GhostVisitor/ESP-Mosaico-gamepad/PROTOCOL.md

# ESP-Mosaico 两用游戏手柄 ↔ 上级单片机 串口协议 & 按键对照表

> 面向**上级单片机**开发者。本文档描述 ESP-Mosaico 两用游戏手柄（CH552T 面板）通过 `P3.1 (TXD)` 上报的串口数据。
> 对应固件:`ESP-Mosaico_gamepad_v1.0.hex`

---

## 1. 物理层

| 项 | 值 |
|---|---|
| 接口 | UART0,**单向发送**(CH552 只发,不收) |
| 引脚 | CH552 `P3.1 = TXD` → 上级单片机 `RX`(另需共地 GND) |
| 电平 | 3.3 V TTL(注意与上级 MCU 电平匹配) |
| 格式 | **19200 bps, 8 数据位, 无校验, 1 停止位(19200 8N1)** |
| 流控 | 无 |

> CH552 的 RXD 在 `P3.0`,本固件未使能接收(`REN=0`)。上级若要回传数据,需自行接 P3.0 并改固件。

---

## 2. 帧格式(定长 5 字节)

```
字节0   字节1   字节2    字节3    字节4
0xA5    0x5A    LO       HI       XOR
帧头1   帧头2   掩码低8位  掩码高4位  校验
```

- `LO` = `mask & 0xFF`
- `HI` = `(mask >> 8) & 0x0F`(只用低 4 位,bit4~bit7 恒为 0)
- `XOR` = `0xA5 ^ 0x5A ^ LO ^ HI`(前 4 字节异或)

`mask` 是 **12 位键位掩码**,`bit n = KEY_(n+1)` 按下(`1` = 按下,`0` = 松开)。

---

## 3. ★ 按键键值对照表(核心)

| bit | mask(hex) | 按键 | 引脚 | 板上位置 | 手柄功能 | 典型帧(仅该键按下) |
|:---:|:---:|:----:|:----:|:---:|:---:|:---|
| 0 | `0x0001` | KEY_1  | P1.0 | SW1 | D-Pad 上 (hat=0) | `A5 5A 01 00 FE` |
| 1 | `0x0002` | KEY_2  | P1.1 | SW2 | D-Pad 左 (hat=6) | `A5 5A 02 00 FD` |
| 2 | `0x0004` | KEY_3  | P1.2 | SW3 | D-Pad 下 (hat=4) | `A5 5A 04 00 FB` |
| 3 | `0x0008` | KEY_4  | P1.3 | SW4 | D-Pad 右 (hat=2) | `A5 5A 08 00 F7` |
| 4 | `0x0010` | KEY_5  | P1.4 | SW5 | Y | `A5 5A 10 00 EF` |
| 5 | `0x0020` | KEY_6  | P1.5 | SW6 | X | `A5 5A 20 00 DF` |
| 6 | `0x0040` | KEY_7  | P1.6 | SW7 | A | `A5 5A 40 00 BF` |
| 7 | `0x0080` | KEY_8  | P1.7 | SW8 | B | `A5 5A 80 00 7F` |
| 8 | `0x0100` | KEY_9  | P3.2 | SW9 | SELECT → Back | `A5 5A 00 01 FE` |
| 9 | `0x0200` | KEY_10 | P3.3 | SW10  | START  → Start | `A5 5A 00 02 FD` |
| 10 | `0x0400` | KEY_11 | P3.4 | SW11  | LT | `A5 5A 00 04 FB` |
| 11 | `0x0800` | KEY_12 | P3.5 | SW12  | RT | `A5 5A 00 08 F7` |
| — | `0x0000` | (无) | — | — | 全松开(空闲) | `A5 5A 00 00 FF` |

**组合键**:多个位同时为 1。例:`0x0C00` = LT+RT 同时按 → `A5 5A 00 0C F3`(已实测通过)。
**注意**:`HI` 只用到低 4 位,所以 `mask` 有效范围是 `0x0000`~`0x0FFF`。

---

## 4. 发送时机

| 场景 | 行为 |
|---|---|
| 键位**发生变化**(按下或松开) | **立即**发送一帧 |
| 键位**保持不变** | 每 **≈400 ms** 发一帧"心跳"(`mask` 内容不变) |
| 上电 | 启动后立即发一帧(通常是 `00 00`) |

> 心跳周期的意义:上级即使一直没按键,也能确认面板在线。
> **实测心跳 388~422 ms**。代码里写的是"主循环 2ms × 100",但本平台上 `DLY_ms(2)` 实测约 4ms,
> 所以真实值约 400 ms。

**上线/掉线判定建议**:超过 **1~2 s** 没收到任何合法帧 ⇒ 判定面板离线。
`K9~K12` 独立按键的帧已实测,均会在按下/松开瞬间立刻发出。

---

## 5. 上级单片机解析代码(可直接抄)

```c
/* ============ 上级 MCU 侧:CH552 面板串口帧解析 ============ */
#include <stdint.h>

#define KP_HEAD0   0xA5
#define KP_HEAD1   0x5A

/* 最新的键位掩码: bit n = KEY_(n+1) 按下 */
volatile uint16_t g_key_mask = 0;

/* 键名表,便于打印调试 */
static const char *const KEY_NAME[12] = {
    "UP","LEFT","DOWN","RIGHT","Y","X","A","B",
    "SELECT","START","LT","RT"
};

/* 5 状态接收机:把 UART 收到的每个字节喂进来(放在接收中断里即可) */
void KP_feed(uint8_t b)
{
    static uint8_t st = 0, lo = 0, hi = 0;

    switch (st) {
    case 0:                                  /* 等帧头1 */
        if (b == KP_HEAD0) st = 1;
        break;
    case 1:                                  /* 等帧头2 */
        st = (b == KP_HEAD1) ? 2 : 0;
        break;
    case 2:                                  /* 掩码低字节 */
        lo = b; st = 3;
        break;
    case 3:                                  /* 掩码高字节 */
        hi = b; st = 4;
        break;
    case 4:                                  /* 校验 */
        if (b == (uint8_t)(KP_HEAD0 ^ KP_HEAD1 ^ lo ^ hi)) {
            g_key_mask = (uint16_t)lo | ((uint16_t)hi << 8);   /* 校验通过才更新 */
        }
        st = 0;
        break;
    default:
        st = 0;
        break;
    }
}

/* 使用示例:查询某个键是否按下 */
#define KEY_DOWN(n)   ((g_key_mask >> (n)) & 1u)     /* n = 0..11 */
/* 例:  if (KEY_DOWN(10)) { /* LT 按下 */ }  */
```

### 关键点

1. **必须校验 XOR**,并且只在校验通过时更新 `g_key_mask`(防串扰/丢字节)。
2. 状态机在**每个字节**上推进,不依赖定时;**乱码会自动回到等帧头**。
3. `g_key_mask` 是**全量状态**(不是"事件"),所以丢一两帧也能在下一帧(≤400 ms 内)自动恢复。
4. 若要"按下瞬间触发一次"的语义,请在上级自己做**边沿检测**:
   ```c
   uint16_t prev = 0;
   ...
   uint16_t changed = g_key_mask ^ prev;      /* 变化的位 */
   uint16_t pressed = g_key_mask & changed;   /* 刚按下的位 */
   uint16_t released = prev & changed;        /* 刚松开的位 */
   prev = g_key_mask;
   ```
5. 面板侧已有 **≈16 ms 消抖**,上级**不需要**再消抖。

---

## 6. 附:同时上报的 USB 手柄(仅供参考,与串口无关)

面板同时把自己虚拟成一个 USB HID 手柄(VID:PID = `0x0079:0x0006`),
报告 7 字节:`[X, Y, Rx, Ry, hat+pad, btnLo, btnHi]`,按键顺序按 W3C 标准手柄布局:

| 标准按钮位 | 0 | 1 | 2 | 3 | 4 | 5 | 6 | 7 | 8 | 9 |
|---|---|---|---|---|---|---|---|---|---|---|
| 功能 | A | B | X | Y | LB | RB | LT | RT | Back | Start |
| 来源 | KEY_7 | KEY_8 | KEY_6 | KEY_5 | — | — | KEY_11 | KEY_12 | KEY_9 | KEY_10 |
