GhostVisitor/ESP-Mosaico-gamepad/hardware/BOM_ESP-Mosaico_gamepad_1.1_Schematic1_1_2026-10-17.xlsx

No. | Quantity | Comment | Designator | Footprint | Value | Manufacturer Part | Manufacturer | Supplier Part | Supplier
1 | 2 | 100nF | C1,C2 | C0603 | 100nF | CC0603KRX7R9BB104 | YAGEO(国巨) | C14663 | LCSC
2 | 2 | LESD8D3.3CAT5G | D1,D2 | SOD-882_L1.0-W0.6-BI |  | LESD8D3.3CAT5G | LRC(乐山无线电) | C172409 | LCSC
3 | 2 | PZ254V-11-10P | H1,H2 | HDR-TH_10P-P2.54-V-M |  | PZ254V-11-10P | XFCN(兴飞) | C492409 | LCSC
4 | 1 | GL0603UG01 | LED1 | LED0603-RD |  | GL0603UG01 | Guiguang light(桂光光电) | C51933293 | LCSC
5 | 1 | SS8550 Y2(RANGE:200-350) | Q1 | SOT-23-3_L2.9-W1.3-P1.90-LS2.4-BR |  | SS8550 Y2(RANGE:200-350) | CJ(江苏长电/长晶) | C8542 | LCSC
6 | 4 | 5.1kΩ | R1,R2,R4,R5 | R0603 | 5.1kΩ | 0603WAF5101T5E | UNI-ROYAL(厚声) | C23186 | LCSC
7 | 1 | 10kΩ | R3 | R0603 | 10kΩ | 0603WAF1002T5E | UNI-ROYAL(厚声) | C25804 | LCSC
8 | 4 | 0Ω | R6,R7,R8,R9 | R0603 | 0Ω | 0603WAF0000T5E | UNI-ROYAL(厚声) | C21189 | LCSC
9 | 12 | SH-6X6X4.3H-CJ | SW1,SW2,SW3,SW4,SW5,SW6,SW7,SW8,SW9,SW10,SW11,SW12 | SW-TH_SH-6X6X4.3H-CJ |  | SH-6X6X4.3H-CJ | SHOU HAN(首韩) | C42416242 | LCSC
10 | 1 | TS-1007S-AR02516 | SW13 | SW-SMD_L6.1-W3.6-LS7.9 |  | TS-1007S-AR02516 | XUNPU(讯普) | C720381 | LCSC
11 | 2 | TS24CA | SW14,SW15 | SW-SMD_2P-TS24CA |  | TS24CA | SHOU HAN(首韩) | C393942 | LCSC
12 | 1 | CH552T | U1 | TSSOP-20_L6.5-W4.4-P0.65-LS6.4-BL |  | CH552T | WCH(南京沁恒) | C111367 | LCSC
13 | 1 | KH-TYPE-C-16P | USB1 | usb-c-smd_kh-type-c-16p |  | KH-TYPE-C-16P | kinghelm(金航标) | C709357 | LCSC
