GhostVisitor/ESP-Mosaico-gamepad/hardware/外壳3D文件.STEP

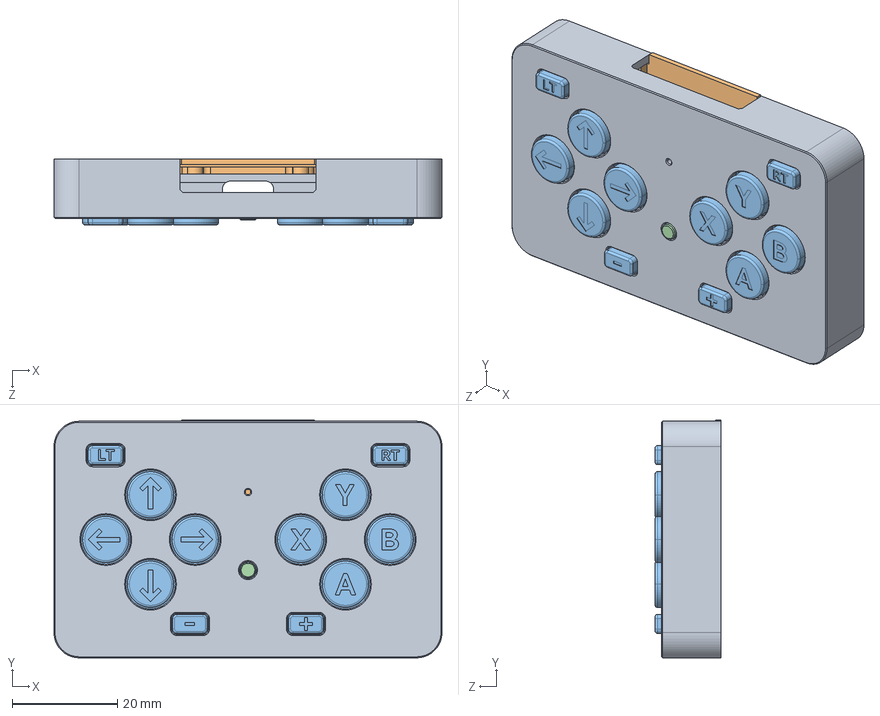
[picture p3: CAD file, 2026-10-17]
hardware/外壳3D文件.STEP
73.6 x 45.1 x 12.5 mm
外接手柄外壳
外接手柄压盖
外接手柄按键
BOOT按键
