GhostVisitor/ESP-Mosaico-gamepad/docs/踩坑记录.md

# 开发踩坑记录（含手册依据）

本工程开发过程中踩到的 4 个**真坑**，全部已实测确认并修复。
如果你也在做 CH55x 的手柄 / 串口项目，希望这些能帮你省几个小时。

---

## 坑 1 ★★★：`P1.2` / `P1.3` 居然还是晶振脚 `XI` / `XO`

### 现象

用 `P1.2`、`P1.3` 接按键（对应 SW3/SW4）：

- 这两个脚的空闲电压只有 **1.67 V ≈ VCC/2**，而其它 `P1.x` 是 3.3 V
- `P1.3` 上的按键**没人碰也一直自己抖**（12 秒静置收到 97 个按键报告）
- `P1.2` 相对安静（它最终被判为高电平，纯属侥幸）

### 根因

CH552 手册（`CH552DS1.PDF`）**第 25 页**，`CLOCK_CFG` 寄存器 bit6：

> **`bOSC_EN_XT`** — `1: P1.2/P1.3 pin used as XI/XO and the oscillator enabled.
> A quartz crystal or ceramic oscillator needs to be externally connected between the XI and XO.`

**第 26 页 8.3 节**：

> `If the external crystal oscillator is turned off, the XI and XO pins can be used as
> P1.2 and P1.3 general-purpose I/O ports.`

也就是说 **`P1.2 = XI`、`P1.3 = XO`**（TSSOP-20 的 17/16 脚）。

**而 PlatformIO 平台 `unit_ch55x` 的 `template/src/system.h` 里，`CLK_config()` 在
`F_CPU == 16000000` 时写的是：**

```asm
ANL CLOCK_CFG, #0b01111000   ; 清掉 bit7 (bOSC_EN_INT)
ORL CLOCK_CFG, #0b01000101   ; 置起 bit6 (bOSC_EN_XT)  <-- 把 P1.2/P1.3 变成 XI/XO!
```

于是这两个脚被**晶振外设接管**：

- GPIO 上拉失效 → 停在振荡器偏置点 ≈ **VCC/2**
- `P1.3`（XO，晶振驱动输出）一直在试图振荡 → 当按键读就是疯狂抖动

### 修复

在 `CLK_config()` 之后显式改回"内部振荡器 + 关闭外部晶振"（**仍是 16 MHz，不改时序**）：

```c
#if F_CPU == 16000000
  SAFE_MOD = 0x55;
  SAFE_MOD = 0xAA;
  CLOCK_CFG = 0x85;   // 1000 0101b
  SAFE_MOD = 0x00;
#endif
```

`0x85` 的含义：

| bit | 值 | 含义 |
|:--:|:--:|---|
| 7 | 1 | `bOSC_EN_INT` 用内部 24 MHz 振荡器 |
| 6 | **0** | `bOSC_EN_XT` **关外部晶振** → 释放 `P1.2`/`P1.3` |
| 4 | 0 | `bROM_CLK_FAST` Fosc(24 MHz) ≥ 16 MHz 用普通档 |
| [2:0] | 101b | `CK_SEL` → Fsys = Fpll/6 = 96/6 = **16 MHz** |

修好后 `P1.2`/`P1.3` 回到 3.3 V，抖动完全消失。

### 排查手法

可以直接反查固件机器码，确认到底往 `CLOCK_CFG(0xB9)` 写了什么：

```python
import re
d = open("firmware.bin", "rb").read()
for op, name in ((b"\x53\xB9", "ANL CLOCK_CFG,#"), (b"\x43\xB9", "ORL CLOCK_CFG,#"),
                 (b"\x75\xB9", "MOV CLOCK_CFG,#")):
    for m in re.finditer(op, d):
        print(name, hex(d[m.start()+2]))
```

> **这是 SDK 的潜在 bug**：任何在 16 MHz 下用到 `P1.2`/`P1.3` 的工程都会中招。
> SDK 自带的 `blink` / `usb_cdc_random` 只是碰巧没用到这两个脚才没暴露。

---

## 坑 2 ★★★：VID/PID 填 `045E:028E` 会导致手柄**完全不可用**

### 现象

想"虚拟成 XBOX360 手柄"，于是 VID/PID 填了微软的 `0x045E / 0x028E`。结果：

```
设备管理器 :  Class = XnaComposite   FriendlyName = 支持 Windows 的 XBOX 360 手柄
XInput 实测 :  XInputGetState -> 1163 (ERROR_DEVICE_NOT_CONNECTED)
子设备     :  没有 "符合 HID 标准的游戏控制器"
```

设备"看起来"被识别了，但**游戏里完全用不了**。

### 根因

Windows 的 INF 会按 VID/PID 直接把它匹配给 **XInput 驱动（`xusb22` / `XnaComposite`）**，
于是走**真·XInput 协议**（厂商自定义接口 `FF/5D/01` + 20 字节报文 + 握手包）。
而本固件是标准 **HID 类**手柄，协议对不上 → 驱动占着设备却读不到数据，
HID 游戏控制器也没建立。

### 修复

用**中性 VID/PID**，让 Windows 加载通用 HID 驱动：

```c
#define USB_VENDOR_ID   0x0079   // 通用 PC 手柄(兼容最好)
#define USB_PRODUCT_ID  0x0006
```

然后再 `joy.cpl` 里就能看到 `HID-compliant game controller` 了。

> 只认 XInput 的游戏？**不要在芯片里解决**，用 PC 侧开源软件桥接：
> [ViGEmBus](https://github.com/nefarius/ViGEmBus) 或 [x360ce](https://github.com/x360ce/x360ce)。

---

## 坑 3 ★★：HID 按键顺序必须符合 W3C《标准手柄》布局

### 现象

在测试网站（如 gamepad-tester）上，按下 **SW9(SELECT)** 显示成 **LT**、
**SW10(START)** 显示成 **RT**。

### 根因

W3C Gamepad「标准映射」的按钮位置是**固定**的：

```
位置: 0  1  2  3  4   5   6   7   8     9
名称: A  B  X  Y  LB  RB  LT  RT  Back  Start
```

而浏览器对**通用 HID 手柄**是**按描述符顺序**把按键依次填进这些位置的。
最初工程把 Back/Start 排在了第 7、8 位，正好落在标准布局的 LT/RT 上。

### 修复

把 HID 按键位按标准顺序重排，并且**扳机不用 Z/Rz 模拟轴**（否则按 LT 会把"右摇杆"顶偏）：

| HID 位 | 1 | 2 | 3 | 4 | 5 | 6 | 7 | 8 | 9 | 10 |
|---|---|---|---|---|---|---|---|---|---|---|
| 功能 | A | B | X | Y | LB | RB | LT | RT | Back | Start |

---

## 坑 4 ★：PowerShell 的 `-shl` / `-bor` 会"跟随左操作数类型"

这个坑害我一度**误判成固件 bug**，值得单独记一笔。

### 现象

自己写的串口解码脚本，`K9~K12` 怎么按都显示 `mask=0x0000`，
而 `K1~K8` 全部正常 —— 看起来像固件的 bit8~bit11 坏了。

### 根因

```powershell
$hi = $bytes[$i + 3]              # 这是 [byte] 类型
$mask = $lo -bor ($hi -shl 8)     # [byte]1 -shl 8 = 256 → 被截断回 byte = 0 !
```

PowerShell 的 `-shl` / `-shr` / `-bor` **结果类型跟左操作数走**。
`[byte]` 移位后溢出会被**静默截断**，于是所有 bit8~bit15 全被抹成 0。

### 修复

```powershell
$mask = [int]$lo -bor ([int]$hi -shl 8)   # 位移/按位运算前先转 [int]
```

改完立刻全部正常：

```
A5 5A 00 01 FE  mask=0x0100  SELECT
A5 5A 00 02 FD  mask=0x0200  START
A5 5A 00 04 FB  mask=0x0400  LT
A5 5A 00 08 F7  mask=0x0800  RT
A5 5A 00 0C F3  mask=0x0C00  LT+RT   ← 组合键也对
```

### 教训

**自己写的测试工具也会骗人。** 当"硬件/Firmware 看起来坏了"时，先确认
数据是不是在**采集/解析环节**就被吃掉了 —— 这次原始字节里明明白白有
`00 01`，是解码脚本丢的。

---

## 附：CH552 手册获取

```bash
curl -L -o CH552DS1.pdf "https://www.wch-ic.com/download/file?id=309"   # 75 页
pip install pypdf
python -c "from pypdf import PdfReader; print(PdfReader('CH552DS1.pdf').pages[24].extract_text())"
```
