GhostVisitor/ESP-Mosaico-gamepad/hardware/ESP-Mosaico两用游戏手柄原理图.pdf

### GND

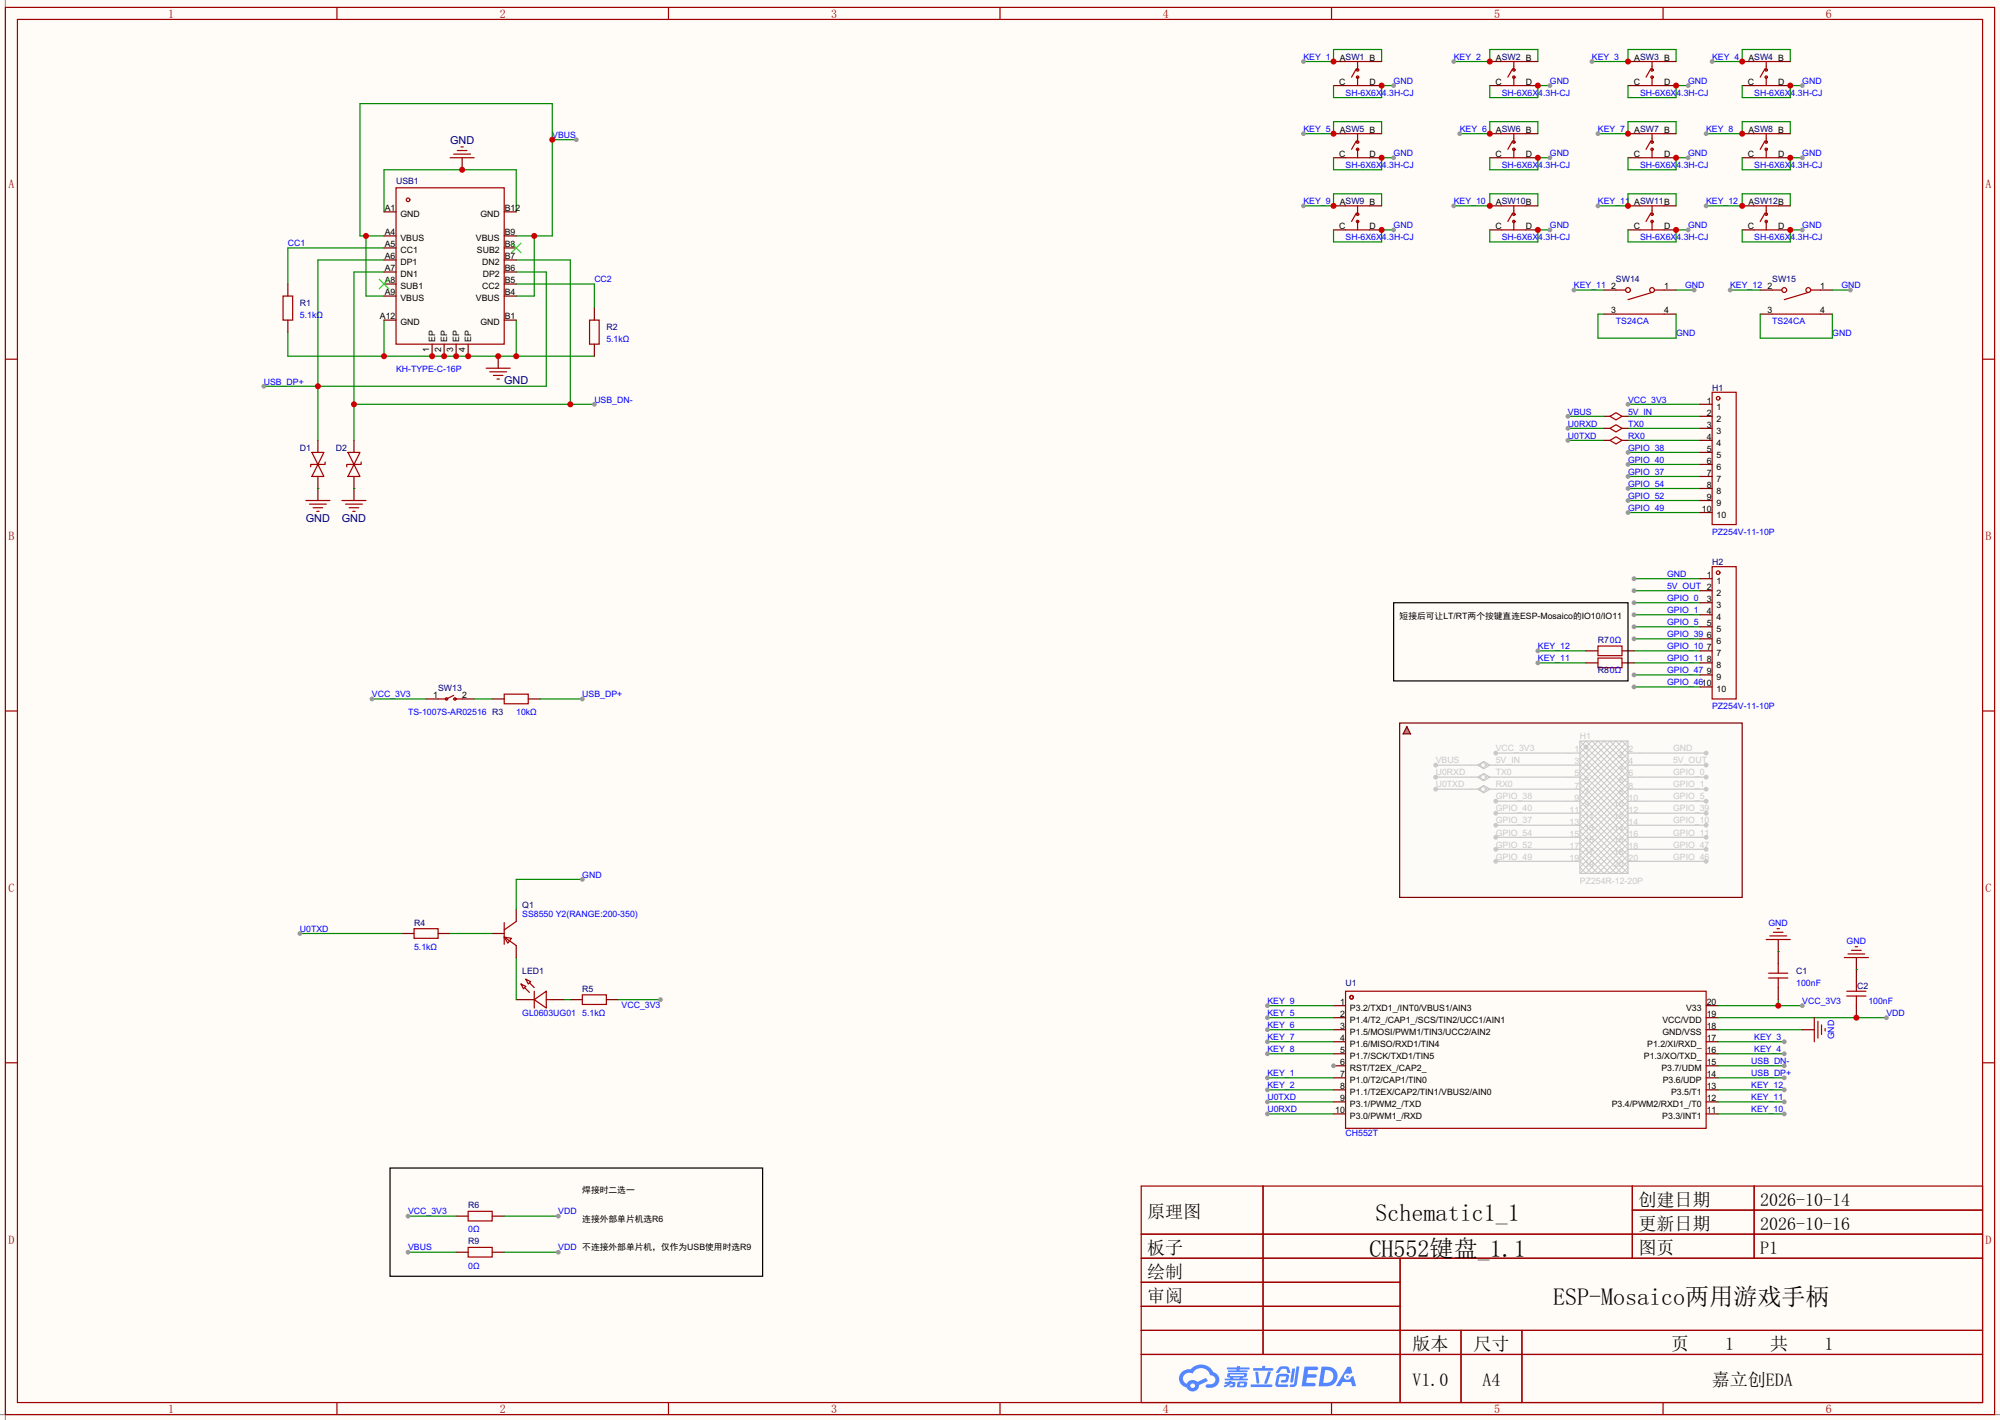
[picture p4: page 1]

原理图 | Schematic1_1 | 创建日期 | 2026-10-14

更新日期 | 2026-10-16

板子 | C H 5 5 2 键 盘 _ 1 . 1 | 图页 | P1
绘制 | | E S P -M o s a i c o 两 用 游 戏 手 柄
审阅
