GhostVisitor/ESP-Mosaico-gamepad/src/gamepad.h

// ===================================================================================
// 键位 -> 手柄报告 映射
// -----------------------------------------------------------------------------------
// 键位到 XBOX360 手柄功能的映射(可自行修改 gamepad.c):
//   SW1  UP     -> D-Pad 上   苦力帽 0
//   SW2  LEFT   -> D-Pad 左   苦力帽 6
//   SW3  DOWN   -> D-Pad 下   苦力帽 4
//   SW4  RIGHT  -> D-Pad 右   苦力帽 2
//   SW5  Y      -> 按键 4  (Y)
//   SW6  X      -> 按键 3  (X)
//   SW7  A      -> 按键 1  (A)
//   SW8  B      -> 按键 2  (B)
//   SW9  SELECT -> 按键 9  (Back)
//   SW10 START  -> 按键 10 (Start)
//   SW11 LT     -> 按键 7  (LT)
//   SW12 RT     -> 按键 8  (RT)
//
// ★ 按键顺序必须严格按 W3C《标准手柄》布局来排:
//     位置: 0  1  2  3  4  5  6  7  8     9
//     名称: A  B  X  Y  LB RB LT RT Back  Start
//   因为浏览器 / 测试网站对“通用 HID 手柄”是**按描述符顺序**把按键填进这些位置的。
//   如果 Back/Start 排在第 7/8 位,网页上就会显示成 LT/RT。
// ===================================================================================

#pragma once
#include <stdint.h>

// 方向键是否同时驱动左摇杆 X/Y(满偏)。
//   1 = 同时驱动(既兼容"读方向键"的游戏,也兼容"读摇杆"的游戏)
//   0 = 只当苦力帽/方向键,左摇杆始终居中
#define GP_DPAD_ALSO_STICK     1

// 手柄报告长度(字节)
#define GP_REPORT_LEN          7

void GAMEPAD_init(void);

// 根据键位掩码更新并(在需要时)发送手柄报告
void GAMEPAD_update(uint16_t keys);
